Gosmann/ESP32-board/REQUISITOS/WhatsApp Image 2020-05-04 at 14.50.01 (1).jpeg

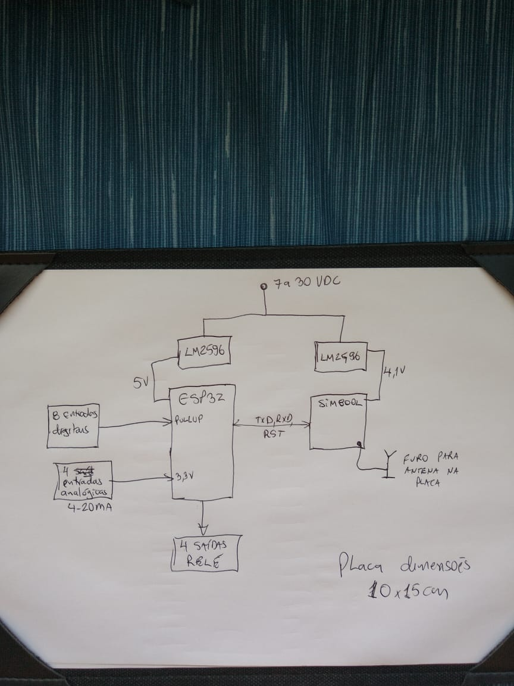
REQUISITOS/WhatsApp Image 2020-05-04 at 14.50.01 (1).jpeg
