Gosmann/ESP32-board/SIMULATIONS/LM2596 4V/4V_analise_divisor.jpg

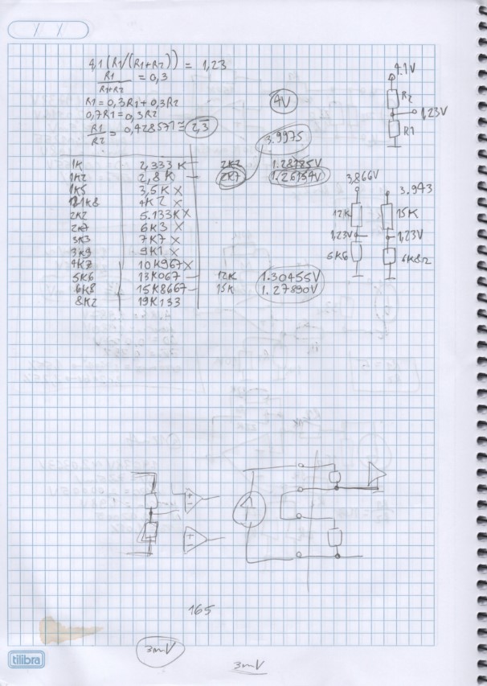
SIMULATIONS/LM2596 4V/4V_analise_divisor.jpg
