Gosmann/ESP32-board/DATASHEETS/analog_inputs.png

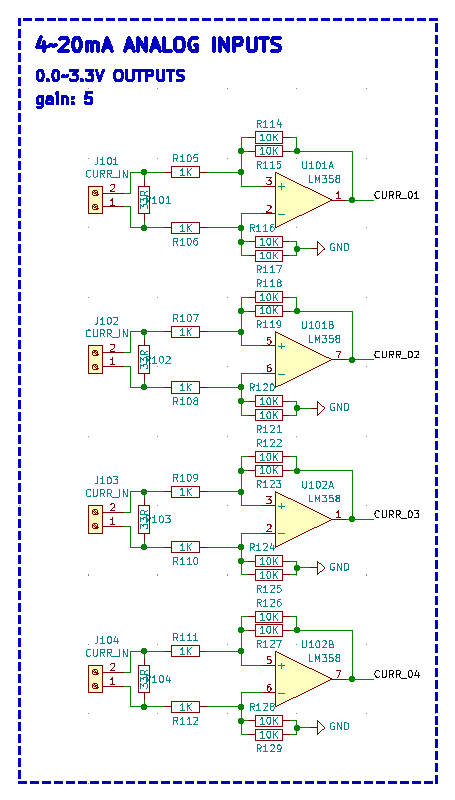
DATASHEETS/analog_inputs.png
