Gosmann/ESP32-board/DATASHEETS/BOARD.png

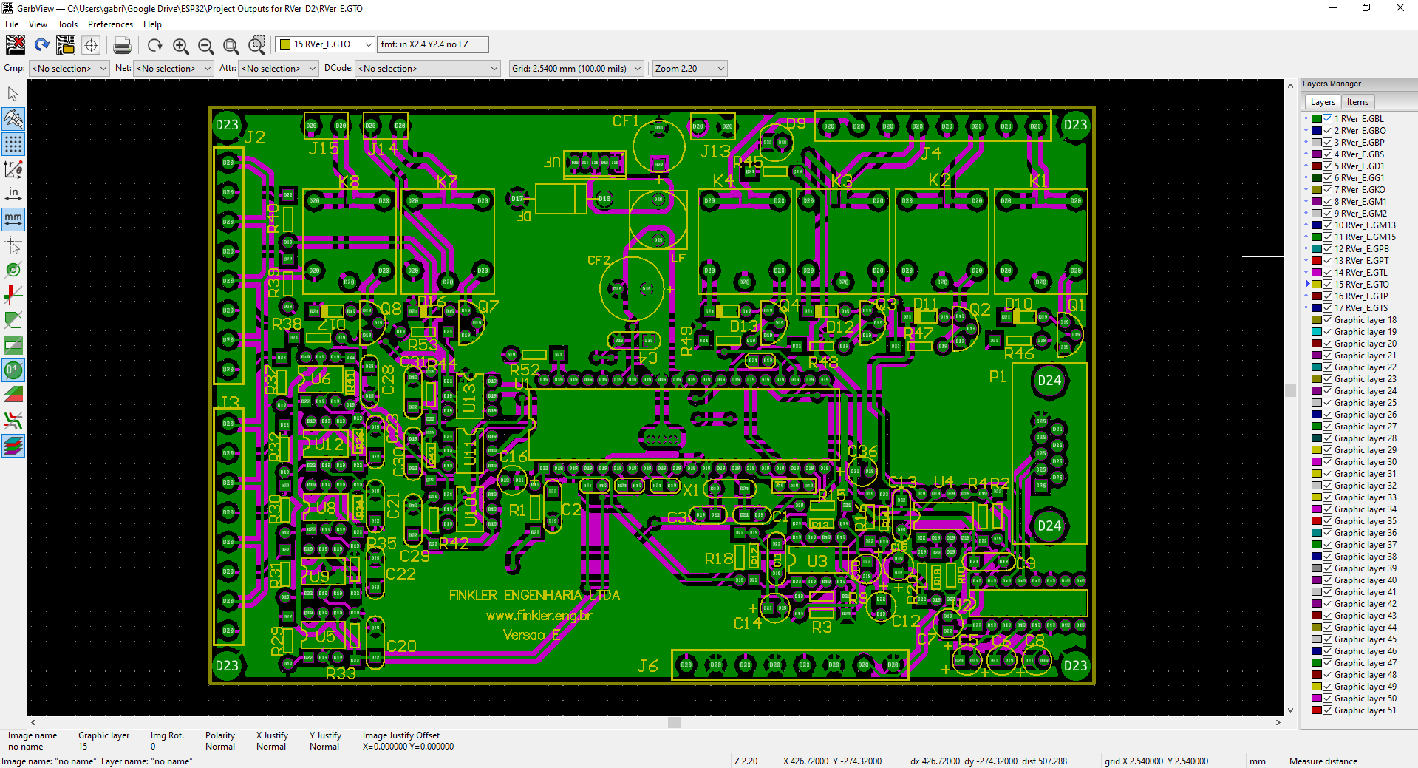
DATASHEETS/BOARD.png
