Gosmann/ESP32-board/DATASHEETS/digital_inputs.png

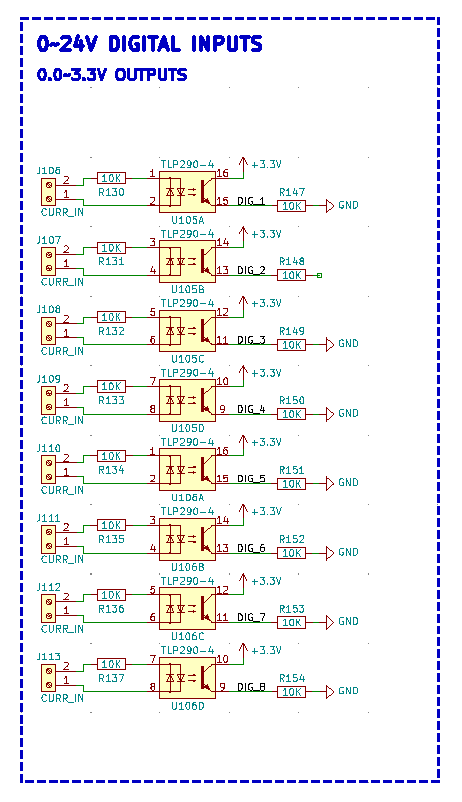
DATASHEETS/digital_inputs.png
