Gosmann/ESP32-board/DATASHEETS/digital_outputs.png

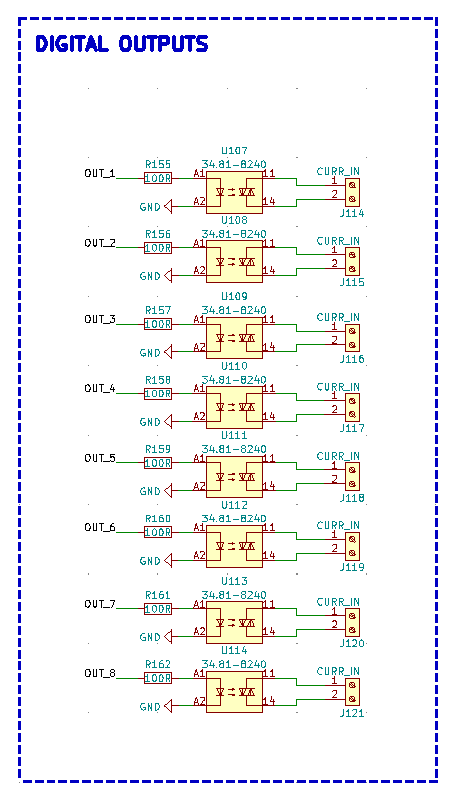
DATASHEETS/digital_outputs.png
