Gosmann/ESP32-board/DATASHEETS/ferrite.png

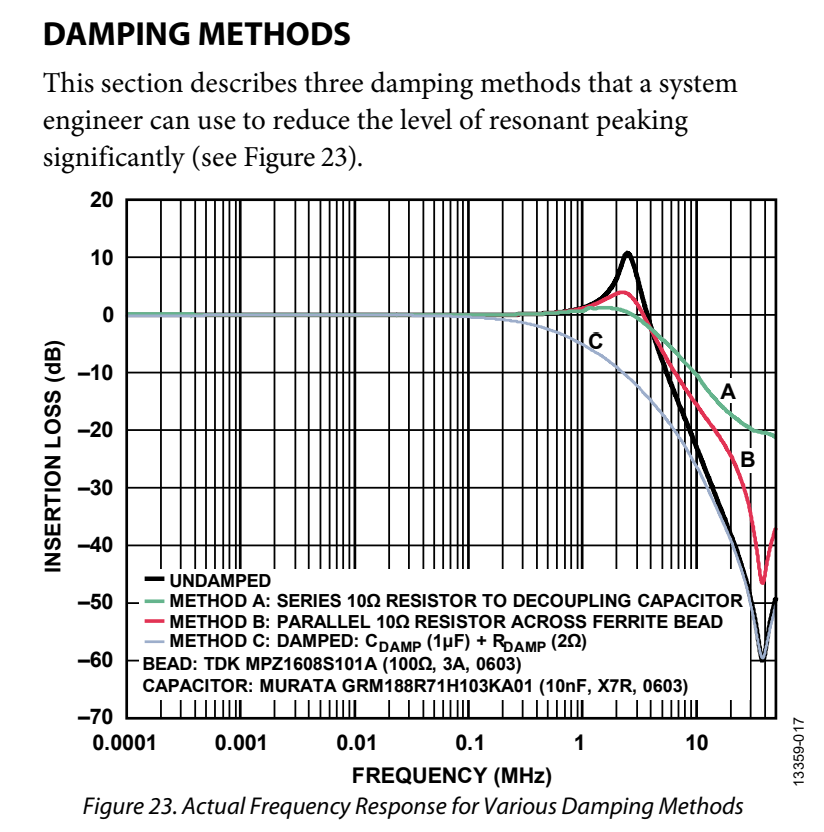
DATASHEETS/ferrite.png
