Gosmann/ESP32-board/DATASHEETS/MOC.png

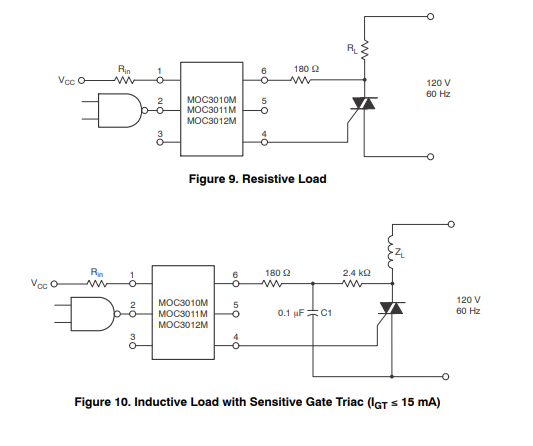
DATASHEETS/MOC.png
