Gosmann/ESP32-board/DATASHEETS/relay_max_voltage.png

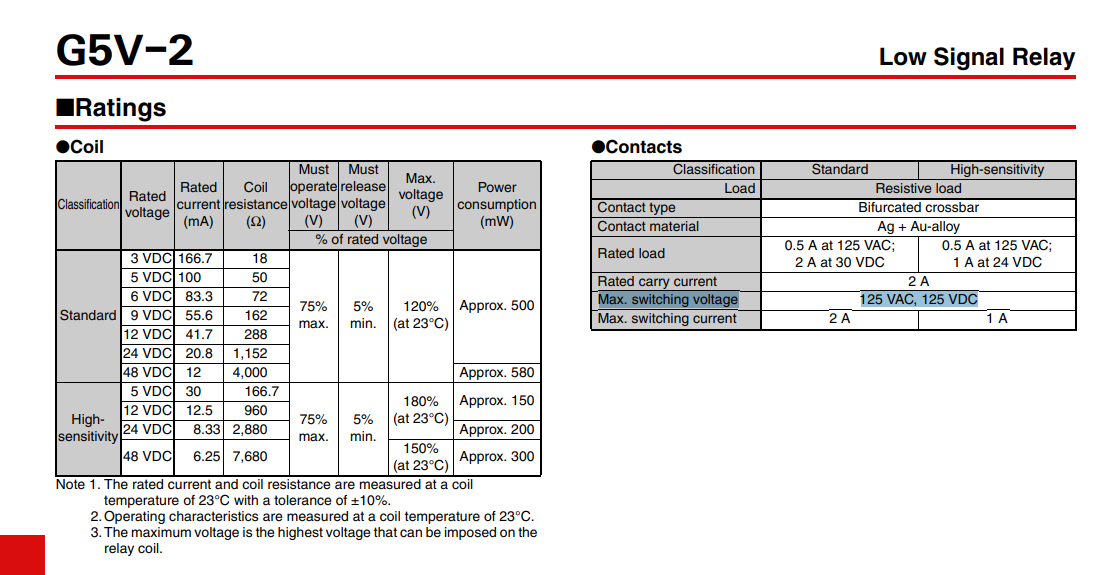
DATASHEETS/relay_max_voltage.png
