Gosmann/ESP32-board/DATASHEETS/solid_state_relay.png

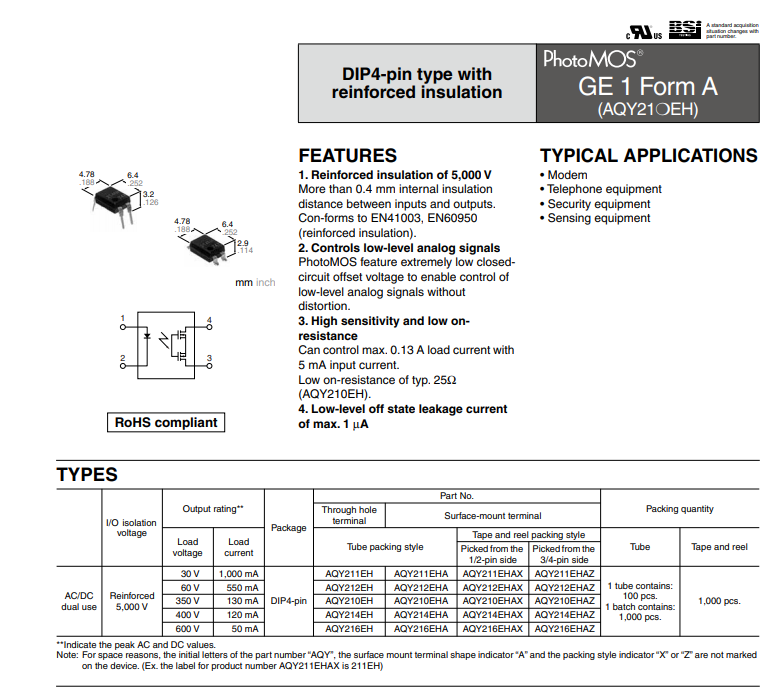
DATASHEETS/solid_state_relay.png
