Gosmann/ESP32-board/DATASHEETS/voltage_regulators.png

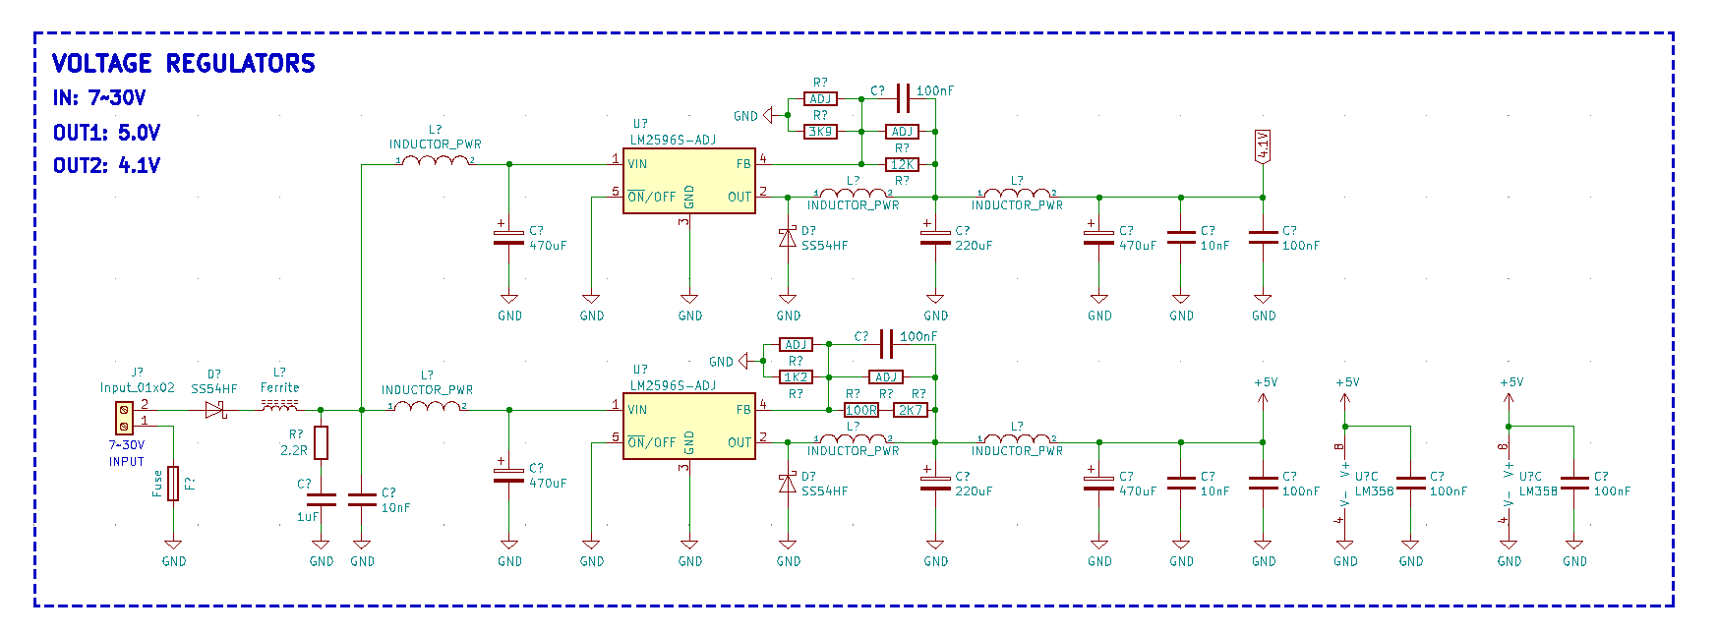
DATASHEETS/voltage_regulators.png
