Gosmann/ESP32-board/FERRITE/ferrite-beads-fig06.png

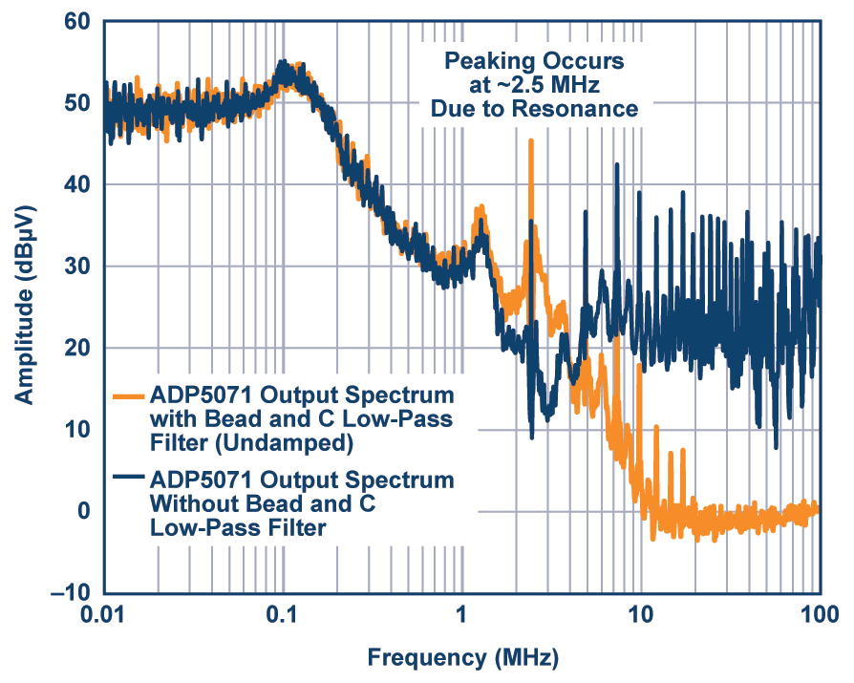
FERRITE/ferrite-beads-fig06.png
