Gosmann/ESP32-board/FERRITE/ferrite-beads-fig09.png

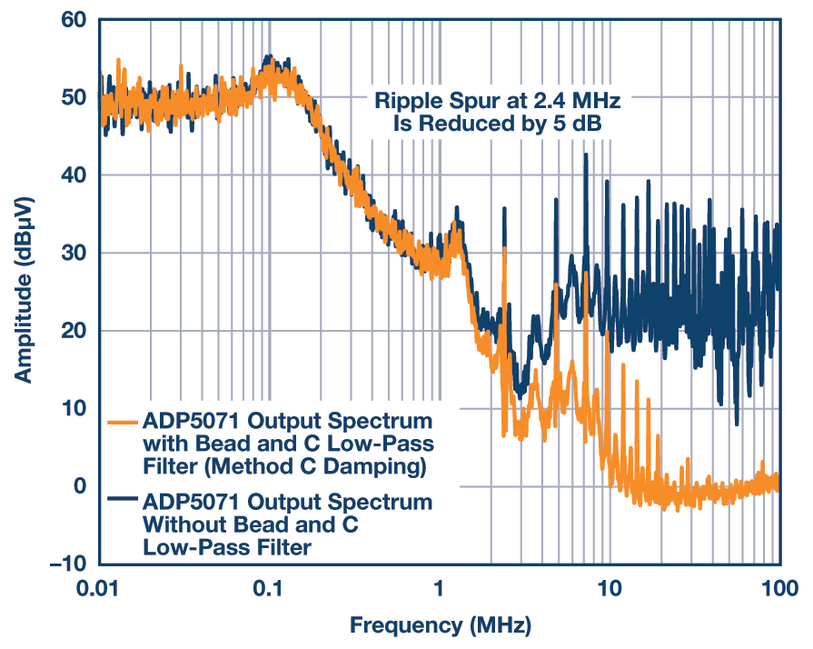
FERRITE/ferrite-beads-fig09.png
