Gosmann/ESP32-board/REQUISITOS/ESP-WROOM-32 DEV KIT.jpeg

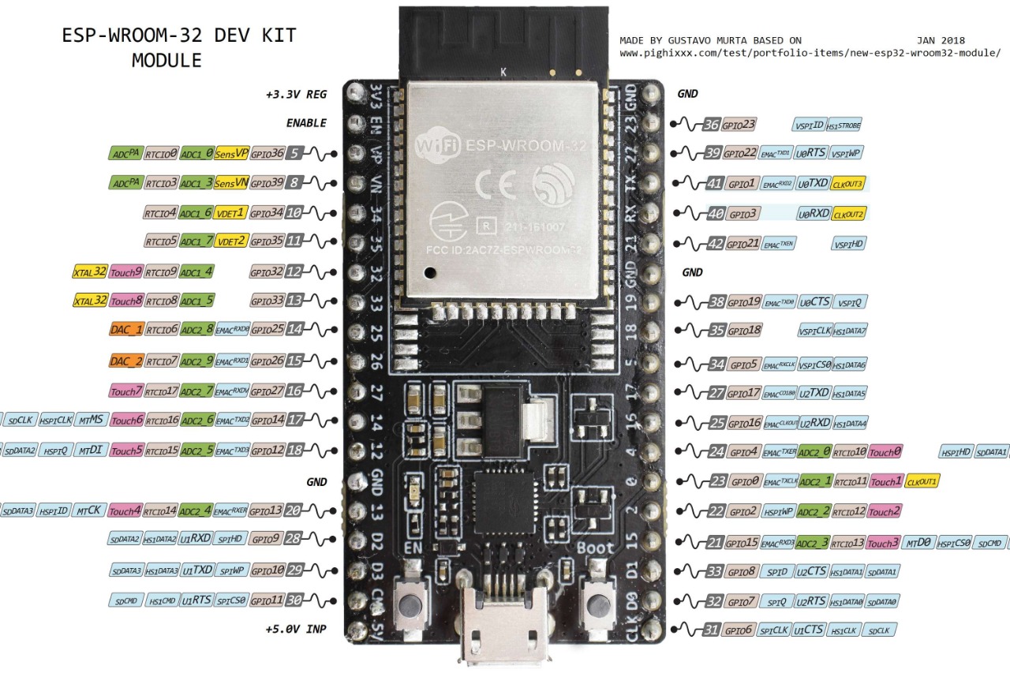
REQUISITOS/ESP-WROOM-32 DEV KIT.jpeg
