Gosmann/ESP32-board/SIMULATIONS/4-20mA/165_ohms.png

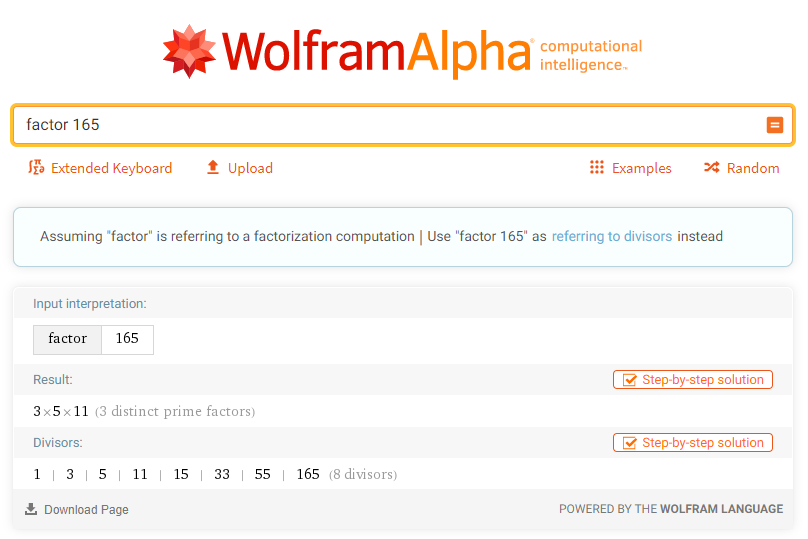
SIMULATIONS/4-20mA/165_ohms.png
