Gosmann/ESP32-board/SIMULATIONS/4-20mA/possible_topologies.jpg

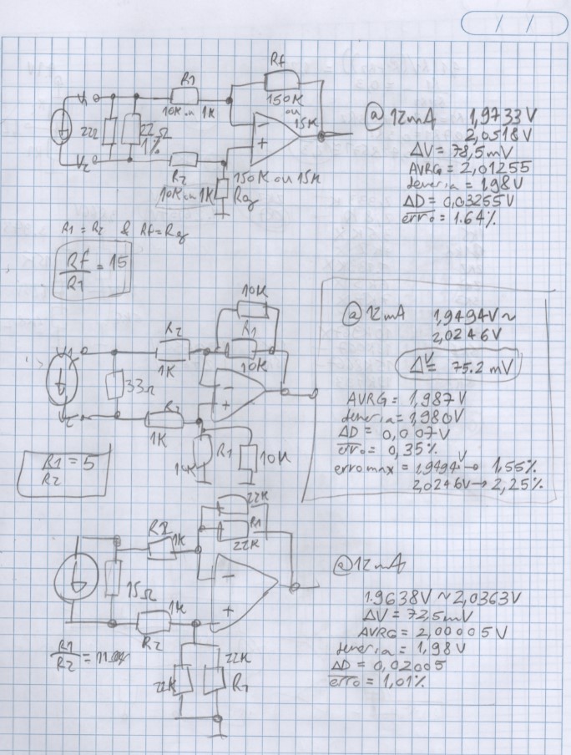
SIMULATIONS/4-20mA/possible_topologies.jpg
