Gosmann/ESP32-board/SIMULATIONS/4-20mA/sim1_mc2.png

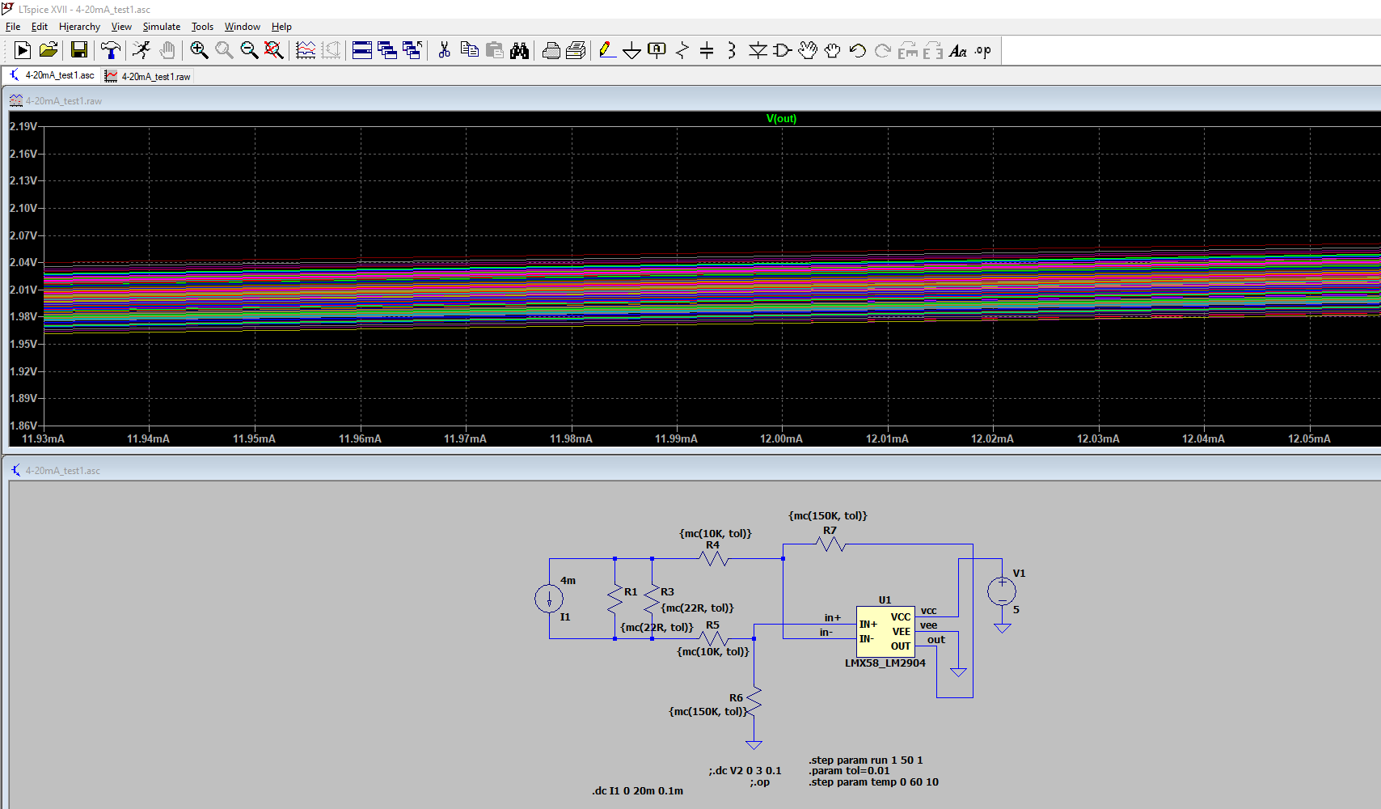
SIMULATIONS/4-20mA/sim1_mc2.png
