Gosmann/ESP32-board/SIMULATIONS/4-20mA/sim2.png

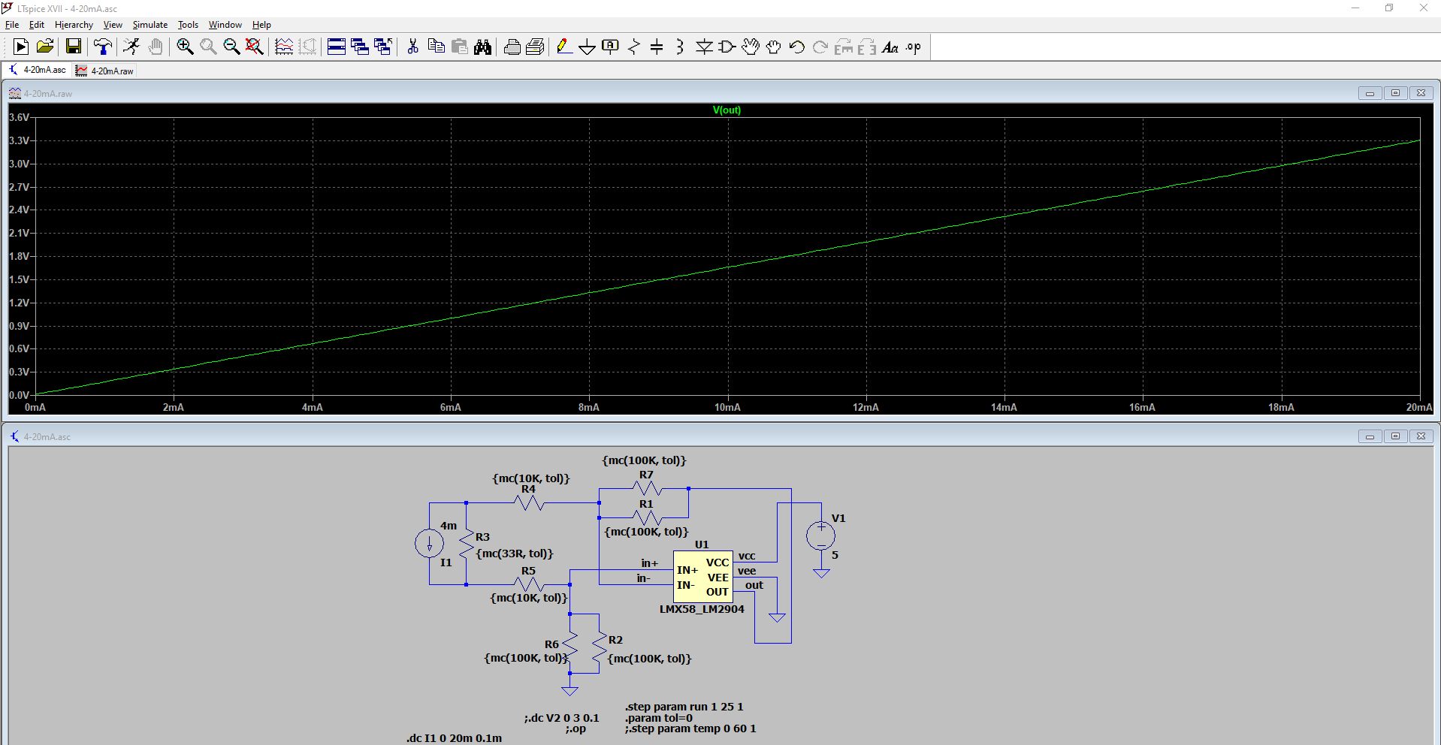
SIMULATIONS/4-20mA/sim2.png
