Gosmann/ESP32-board/SIMULATIONS/LM2596 5V/5V_analise_divisor.jpg

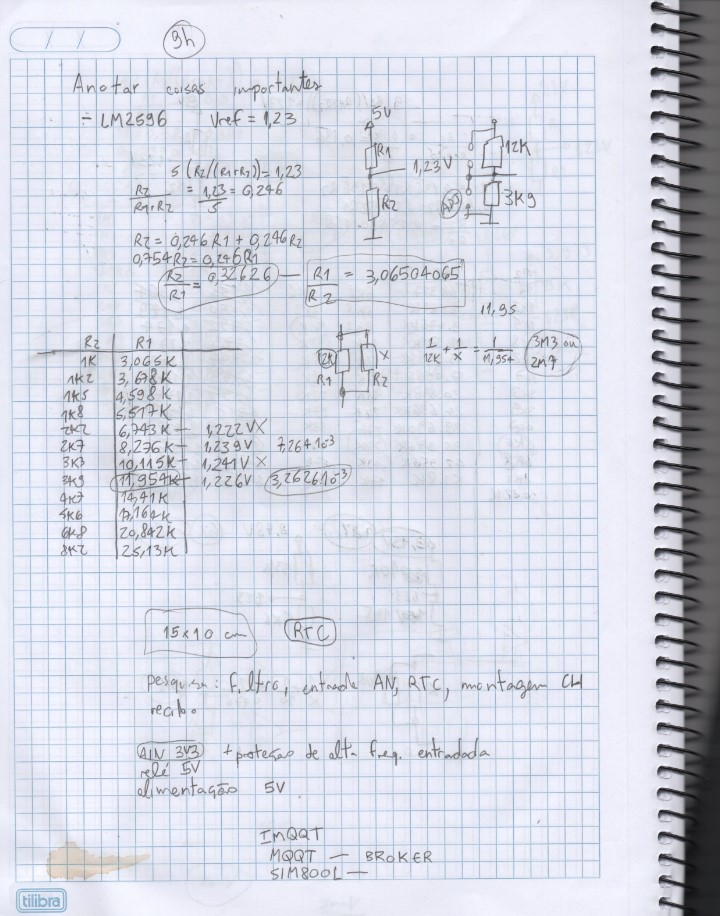
SIMULATIONS/LM2596 5V/5V_analise_divisor.jpg
