Gosmann/ESP32-board/SIMULATIONS/RELAY/relay.png

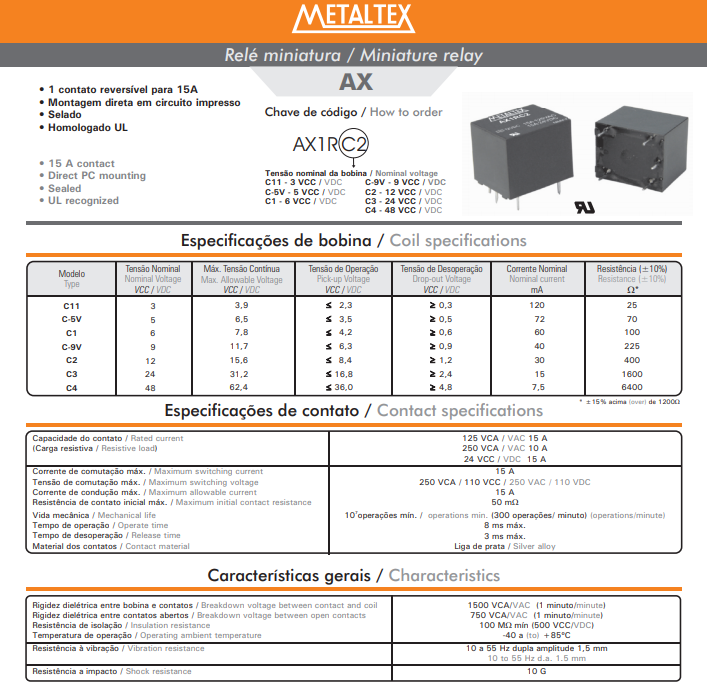
SIMULATIONS/RELAY/relay.png
