Gosmann/ESP32-board/SIMULATIONS/4-20mA/circuit_test.ods

I (mA) | V (V)
0.002 | 0.022
4.040 | 0.638
8.001 | 1.243
12.104 | 1.863
16.047 | 2.474
20.097 | 3.091
24.030 | 3.527
