Gosmann/ESP32-board/SIMULATIONS/LM2596 4V/4V_efficiency_test.png

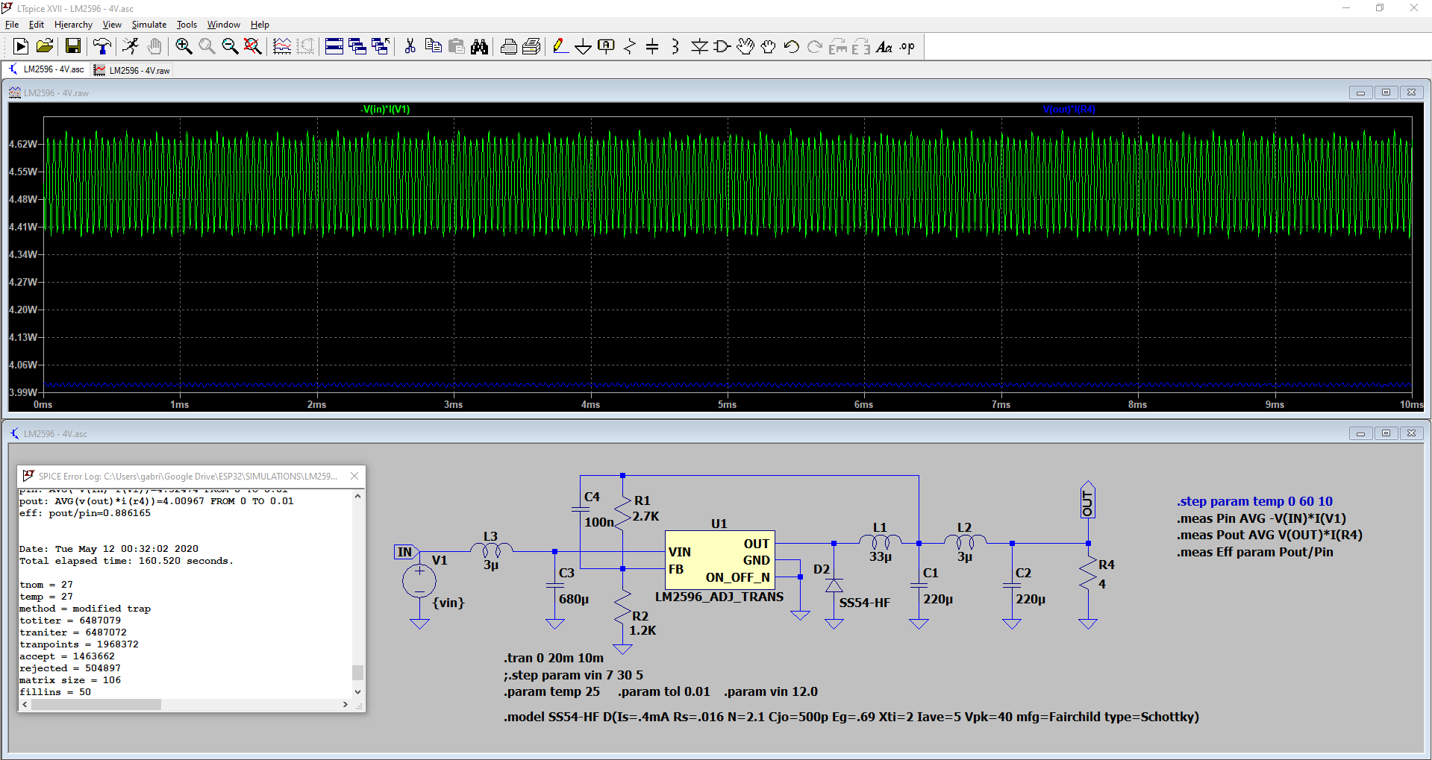
SIMULATIONS/LM2596 4V/4V_efficiency_test.png
