Gosmann/ESP32-board/SIMULATIONS/LM2596 5V/5V_efficiency_test.png

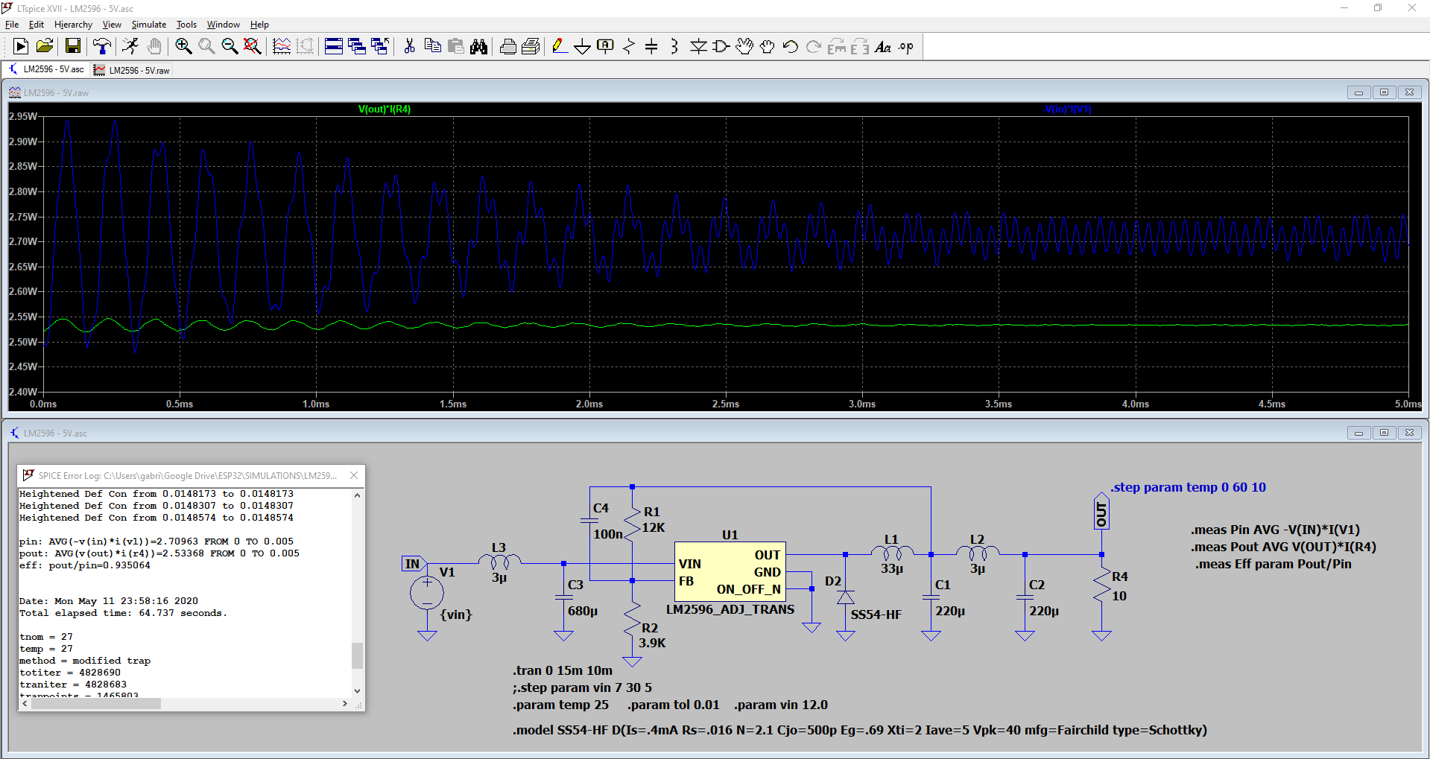
SIMULATIONS/LM2596 5V/5V_efficiency_test.png
