Gosmann/ESP32-board/SIMULATIONS/LM2596 5V/5V_ripple_test.png

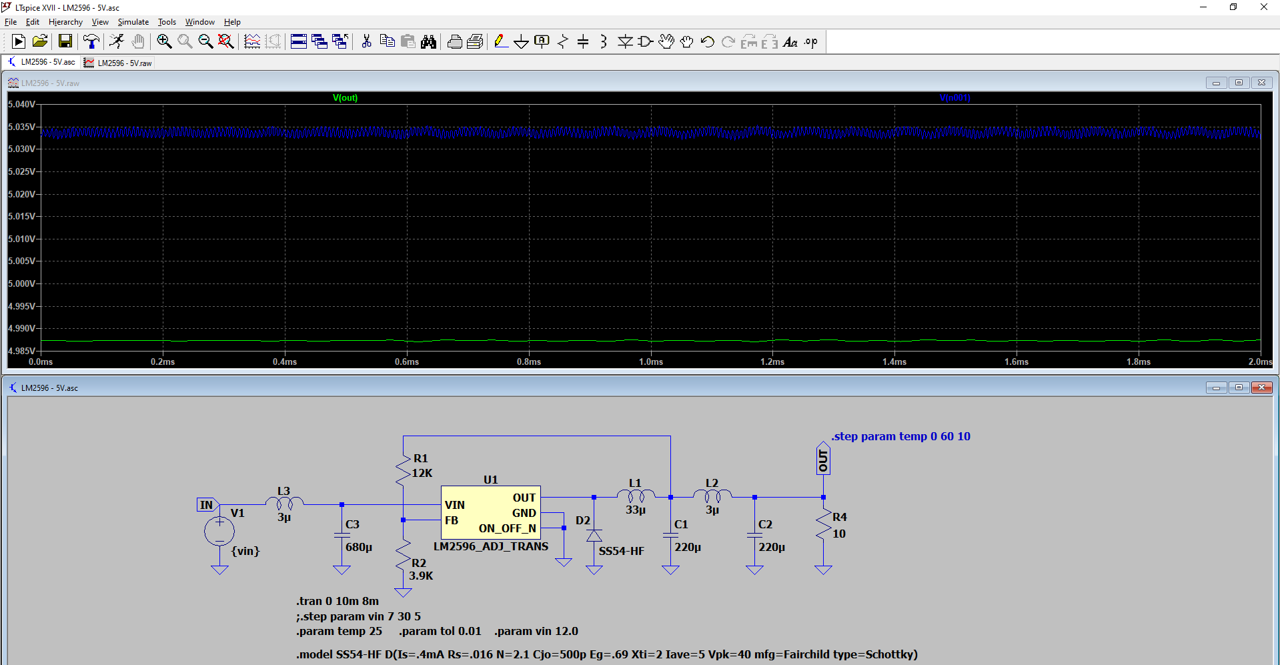
SIMULATIONS/LM2596 5V/5V_ripple_test.png
