Gosmann/ESP32-board/SIMULATIONS/LM2596 9V/RESULTS/9V_OUT_10V_IN_TEMP_SWEEP.png

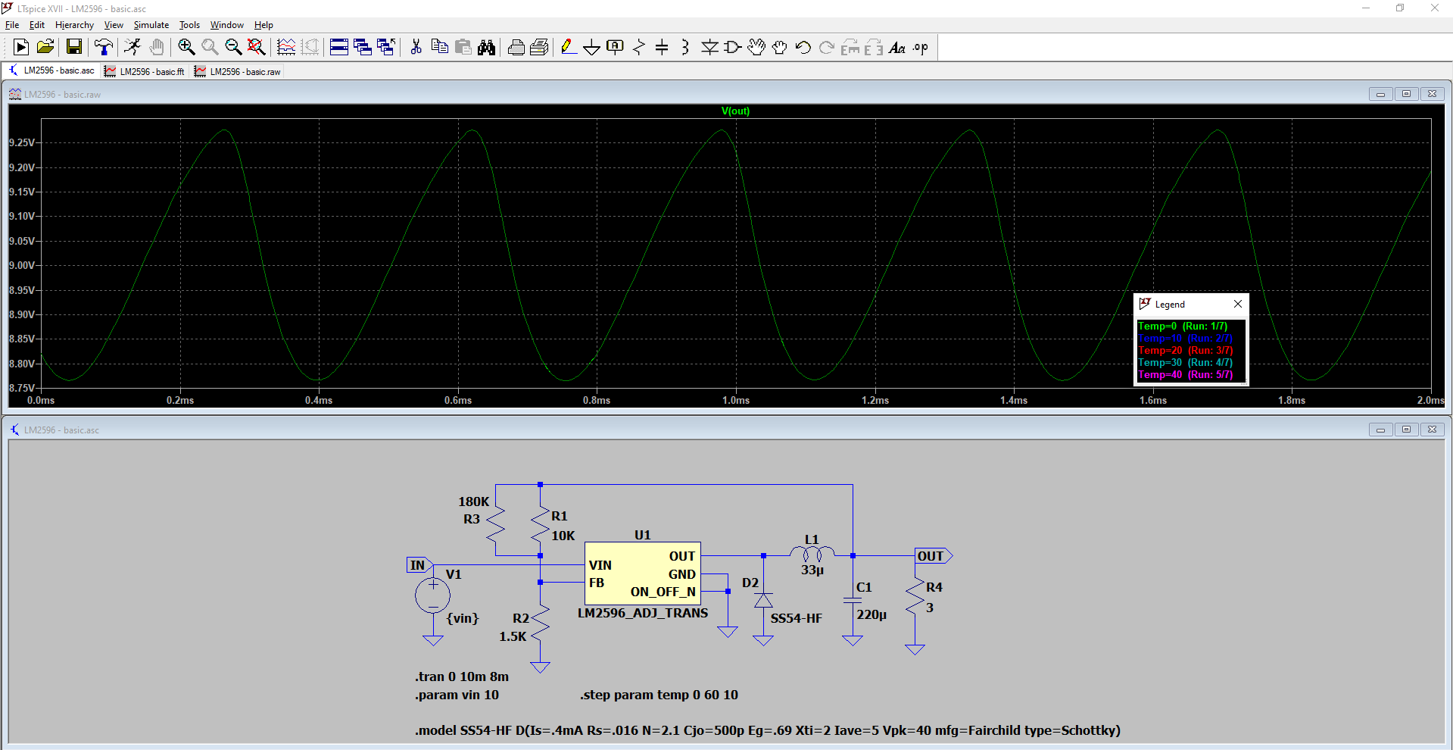
SIMULATIONS/LM2596 9V/RESULTS/9V_OUT_10V_IN_TEMP_SWEEP.png
