Gosmann/ESP32-board/SIMULATIONS/OPTO/opto_test1.png

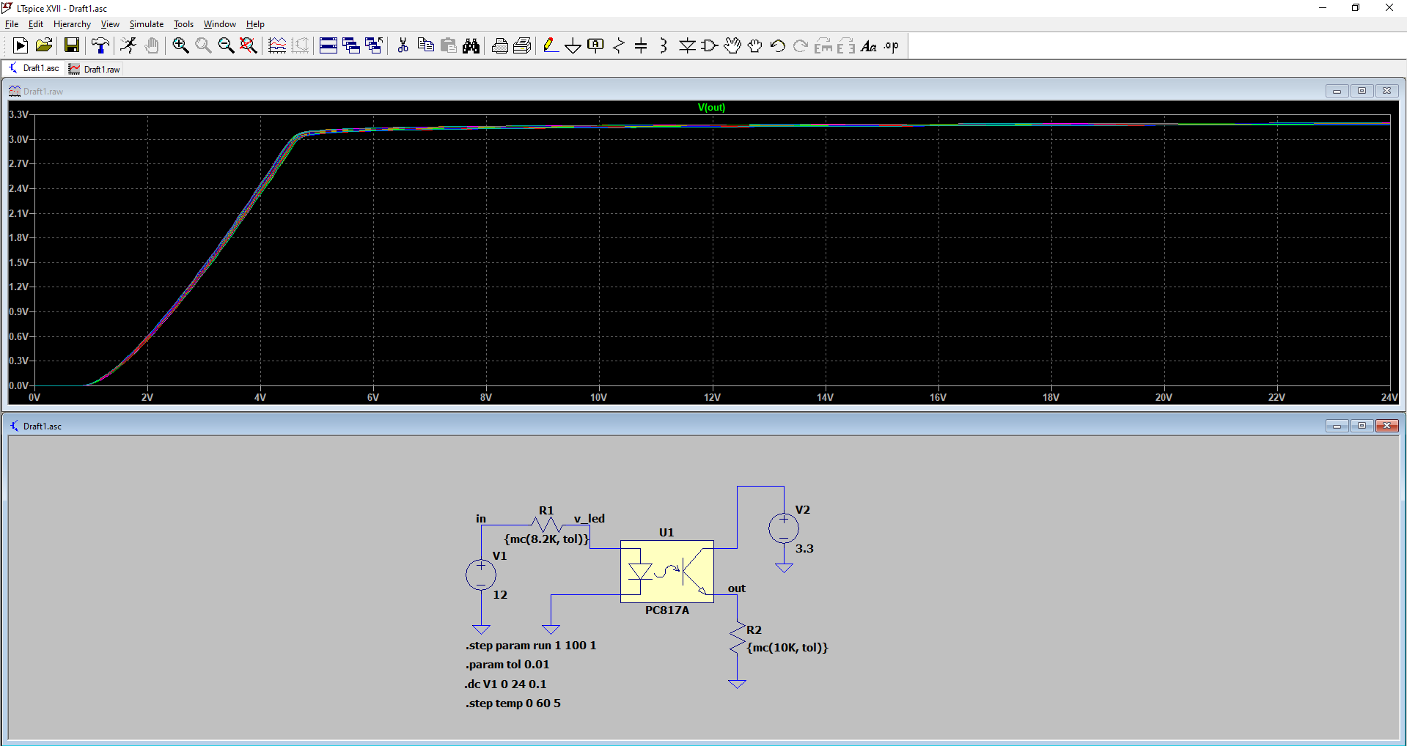
SIMULATIONS/OPTO/opto_test1.png
