Gosmann/ESP32-board/SIMULATIONS/OPTO/opto_test2.png

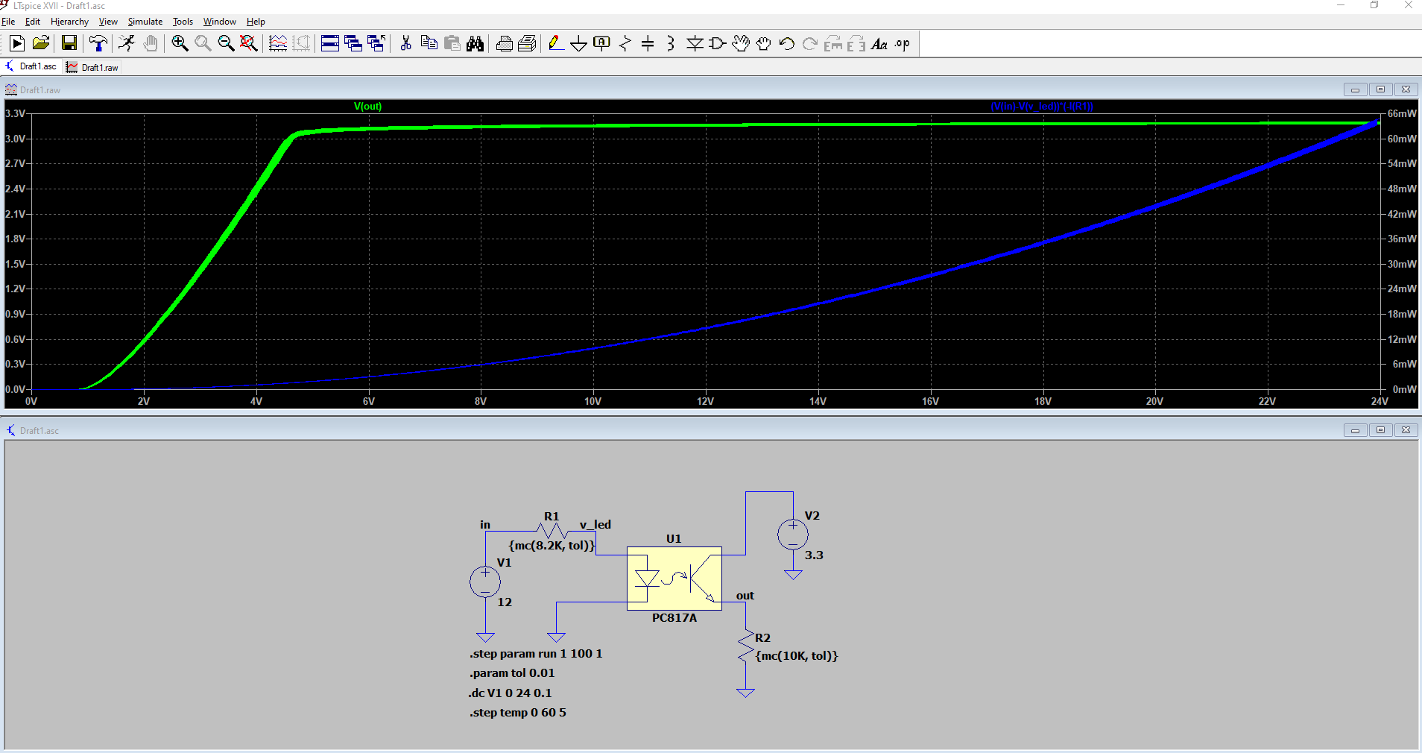
SIMULATIONS/OPTO/opto_test2.png
