Gosmann/ESP32-board/SIMULATIONS/RELAY/test_high.png

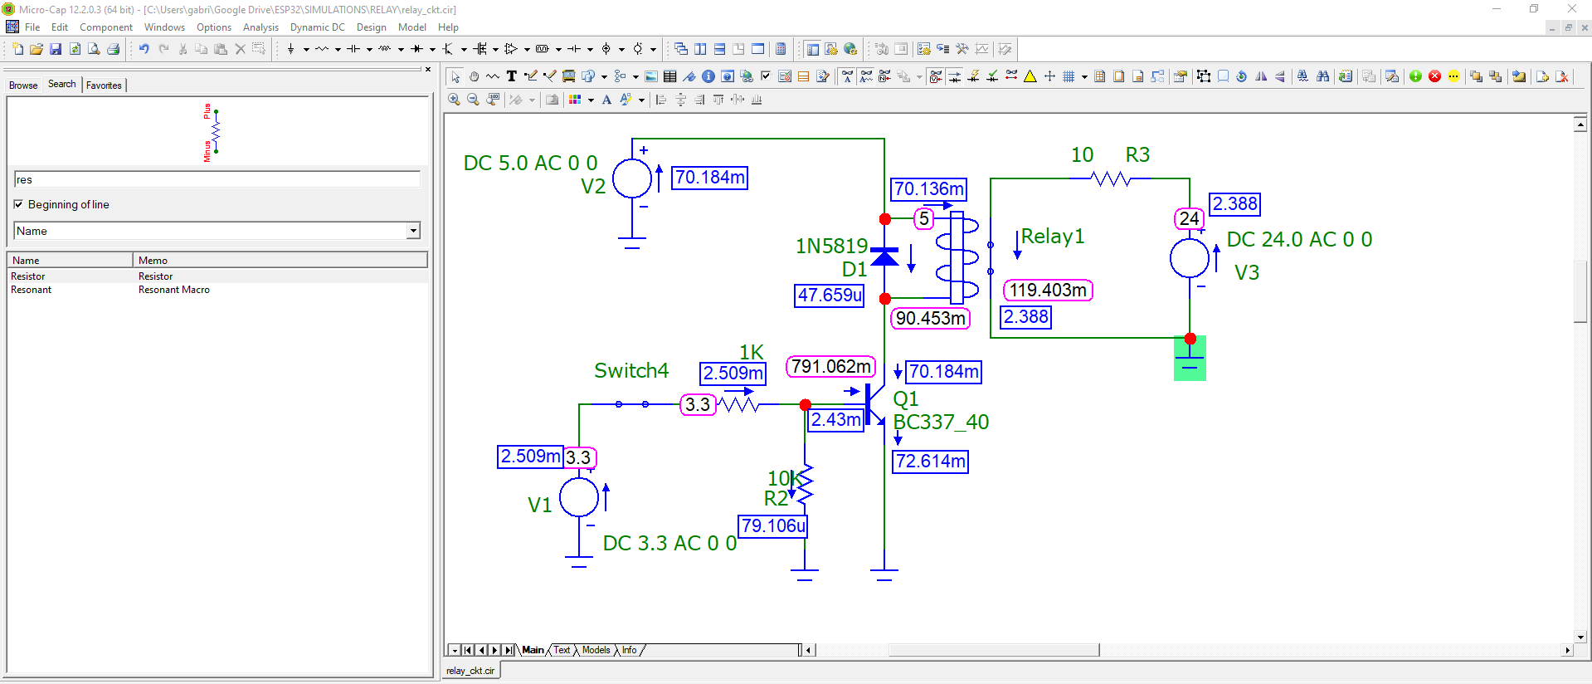
SIMULATIONS/RELAY/test_high.png
