Gosmann/ESP32-board/SIMULATIONS/RELAY/test_low.png

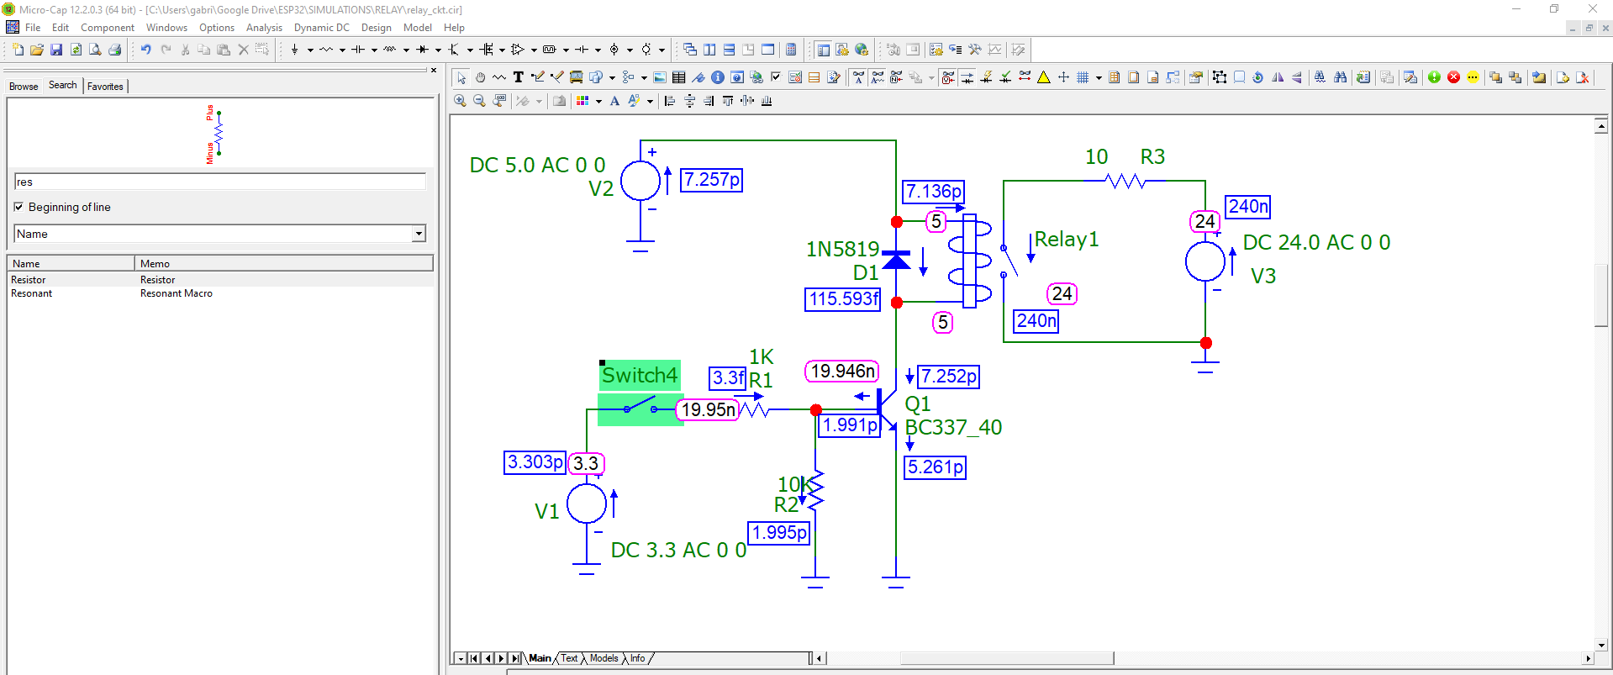
SIMULATIONS/RELAY/test_low.png
