Gosmann/ESP32-board/ESP32-BOARD/ESP32-BOARD.pdf

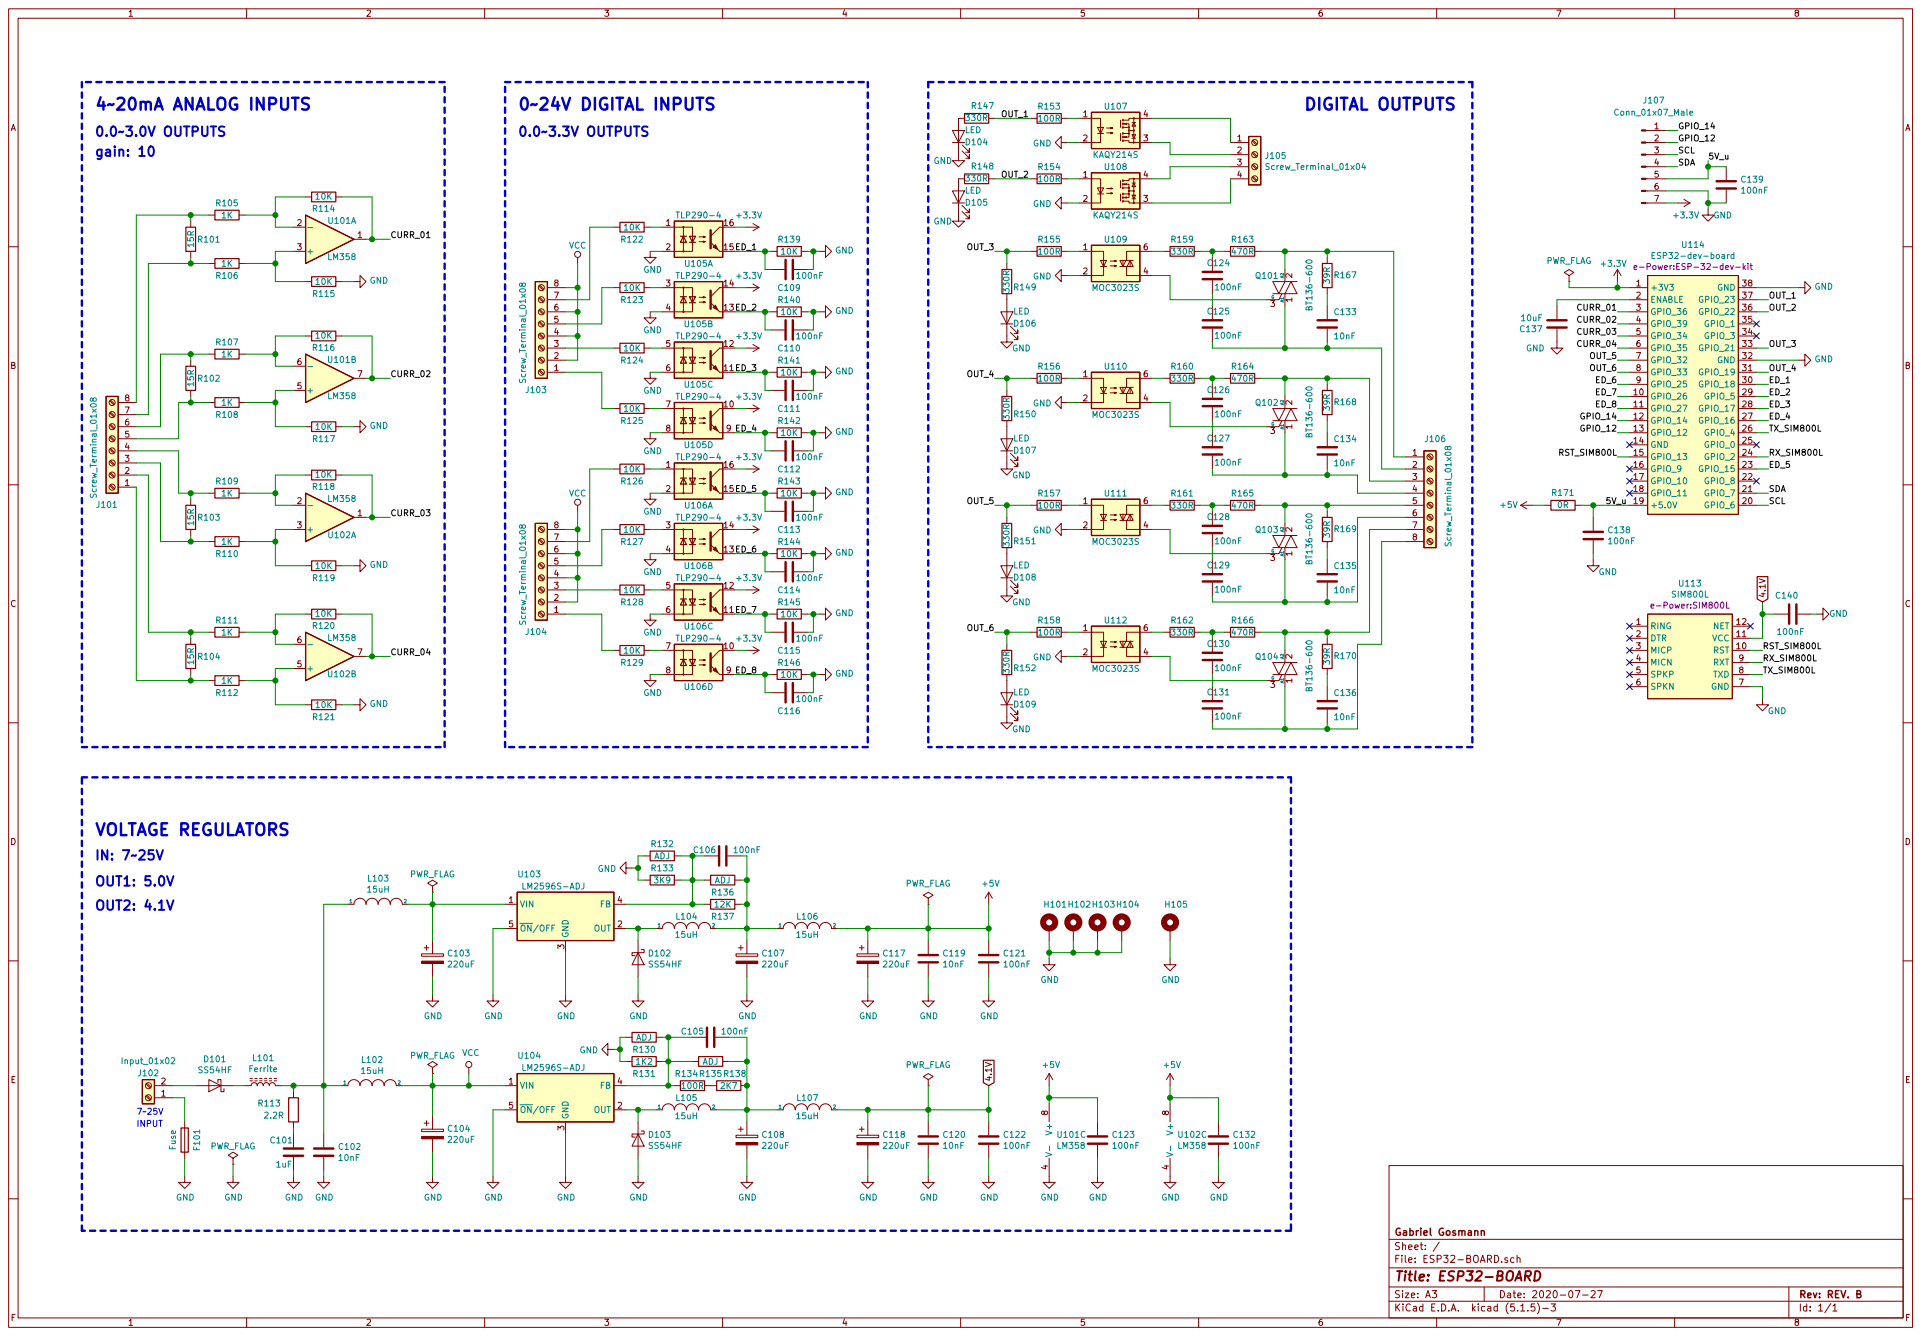
[picture p40: page 1]

e-Power:ESP-32-dev-kit 1

File: ESP32-BOARD.sch Sheet: / Gabriel Gosmann
