Gosmann/ESP32-board/SIMULATIONS/4-20mA/4-20mA_test1.asc

I1: current; 4m
R1: res; {mc(100K, tol)}
R2: res; {mc(100K, tol)}
R3: res; {mc(33R, tol)}; tol=1
R4: res; {mc(10K, tol)}
R5: res; {mc(10K, tol)}
R6: res; {mc(100K, tol)}
R7: res; {mc(100K, tol)}
U1: LMX58_LM2904
V1: voltage; 5
Named nets: 0, out, vcc, vee, in-, in+
;.dc V2 0 3 0.1
.step param run 1 50 1
.param tol=0.01
.step param temp 0 60 10
;.op
.dc I1 0 20m 0.1m
