Gosmann/ESP32-board/SIMULATIONS/MODELS/moc_308x_test.asc

R1: res; 10R
R9: res; 100
U2: TRIAC; BTA12-600B
V1: voltage; SINE(0 400 50)
Named nets: 0, 3, 2
.tran 200m
.include MOC308x.lib
.include C:\\Users\\gabri\\Google Drive\\ESP32\\SIMULATIONS\\MODELS\\st_standard_snubberless_triacs.lib
