Gosmann/ESP32-board/SIMULATIONS/4-20mA/4-20mA.asc

U1: LMX58_LM2904
V1: voltage; 5
Named nets: 0, out, vcc, vee, in-, in+
.tran 0 10m 0
