Gosmann/ESP32-board/SIMULATIONS/LM2596 4V/LM2596 - 4V.asc

C1: cap; 220µ
C2: cap; 220µ
C3: cap; 680µ
C4: cap; 100n
D2: diode; SS54-HF
L1: ind; 15µ; Rser=0.093
L2: ind; 15µ; Rser=0
L3: ind; 15µ; Rser=0.093
R1: res; 2.7K
R2: res; 1.2K
R4: res; 4; tol=1
U1: LM2596_ADJ_TRANS
V1: voltage; {vin}
Named nets: 0, OUT, IN
.tran 0 100m 10m
.model SS54-HF D(Is=.4mA Rs=.016 N=2.1 Cjo=500p Eg=.69 Xti=2 Iave=5 Vpk=40 mfg=Fairchild type=Schottky)
;.step param vin 7 30 5
.param temp 25
.step param temp 0 60 10
.param tol 0.01
.param vin 12.0
.meas Pin AVG -V(IN)*I(V1)
.meas Pout AVG V(OUT)*I(R4)
.meas Eff param Pout/Pin
