Gosmann/ESP32-board/SIMULATIONS/LM2596 5V/LM2596 - 5V.asc

C1: cap; 220µ
D2: diode; SS54-HF
L1: ind; 33µ; Rser=0.093
R1: res; 10K; tol=1
R2: res; 1.5K; tol=1
R3: res; 180K; tol=1
R4: res; 18; tol=1
U1: LM2596_ADJ_TRANS
V1: voltage; {vin}
Named nets: 0, OUT, IN
.tran 0 10m 8m
.model SS54-HF D(Is=.4mA Rs=.016 N=2.1 Cjo=500p Eg=.69 Xti=2 Iave=5 Vpk=40 mfg=Fairchild type=Schottky)
.param vin=16.8
.param temp 25
.step param temp 0 60 10
