Gosmann/ESP32-board/SIMULATIONS/OPTO/opto.asc

R1: res; {mc(8.2K, tol)}
R2: res; {mc(10K, tol)}
U1: PC817A
V1: voltage; 12
V2: voltage; 3.3
Named nets: 0, out, v_led, in
.dc V1 0 24 0.1
.step temp 0 60 5
.param tol 0.01
.step param run 1 100 1
