Gosmann/ESP32-board/(list of files, drawings)

Other design files:
Project Outputs for modem2/Project Outputs for modem/PCB2.PcbDoc
SIMULATIONS/MODELS/en.standard_snubberless_triacs_pspice (1)/standard_snubberless_triacs_Pspice/st_standard_snubberless_triacs.olb
