Gosmann/ESP32-board/ESP32-BOARD/ESP32-BOARD.kicad_pcb

## KiCad design ESP32-BOARD/ESP32-BOARD.kicad_pcb (2020-11-04)

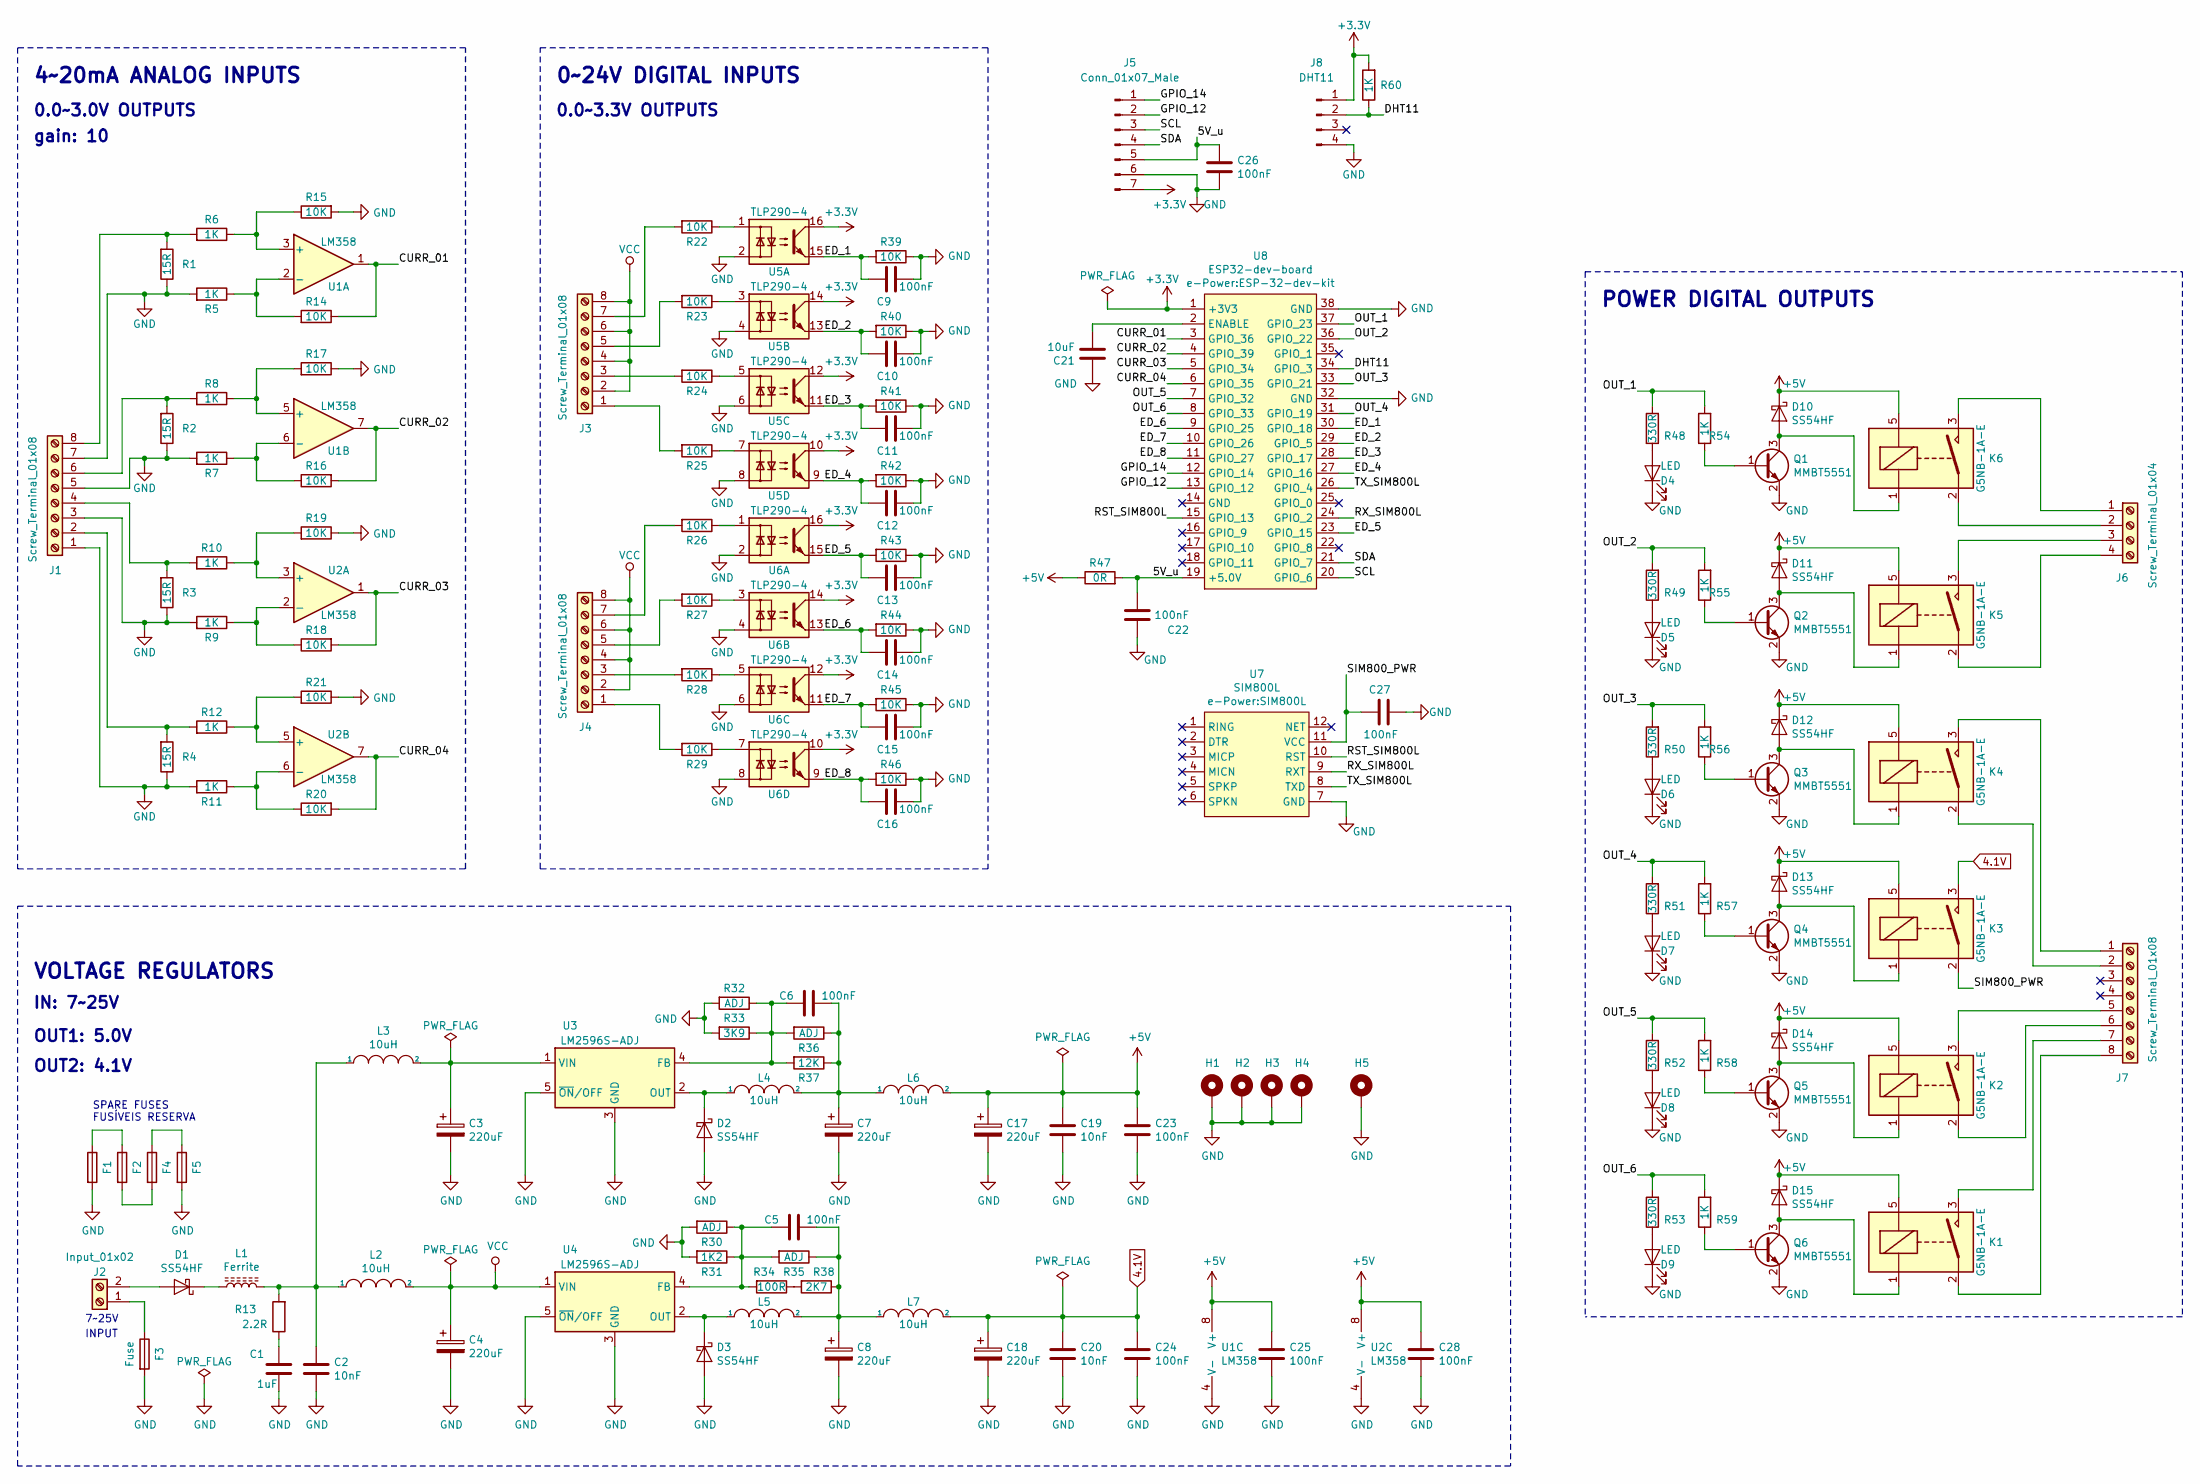
[picture p41: schematic ESP32-BOARD.sch]

Parts:
C1: 1uF; C_0805_2012Metric; LCSC C28323
C2, C19, C20: 10nF; C_0805_2012Metric; LCSC C1710
C3, C4, C7, C8, C17, C18: 220uF; CP_Elec_8x10; LCSC C311611
C5, C6, C9, C10, C11, C12, C13, C14, C15, C16, C22, C23, C24, C25, C26, C27, C28: 100nF; C_0805_2012Metric; LCSC C49678
C21: 10uF; C_0805_2012Metric; LCSC C15850
D1, D2, D3, D10, D11, D12, D13, D14, D15: SS54HF; DO-214AC; LCSC C22452
D4, D5, D6, D7, D8, D9: LED; LED_0805_2012Metric; LCSC C84256
F1, F2, F3, F4, F5: Fuse; FUSE_1206_3216Metric; LCSC C182445
H1, H2, H3, H4: MountingHole_Pad; MountingHole_4mm_Pad_Via
H5: MountingHole_Pad; MountingHole_3.2mm_M3_Pad
J1, J3, J4, J7: Screw_Terminal_01x08; TerminalBlock_Phoenix_MKDS-1,5-8-5.08_1x08_P5.08mm_Horizont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
J2: Input_01x02; TerminalBlock_Phoenix_MKDS-1,5-2_1x02_P5.00mm_Horizontal
J5: Conn_01x07_Male; PinHeader_1x07_P2.54mm_Horizontal
J6: Screw_Terminal_01x04; TerminalBlock_Phoenix_MKDS-1,5-4-5.08_1x04_P5.08mm_Horizont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
J8: DHT11; PinHeader_1x04_P2.54mm_Vertical
K1, K2, K3, K4, K5, K6: G5NB-1A-E; Relay_SPST_Omron-G5Q-1A
L1: Ferrite; FB_0603_1608Metric; LCSC C1002
L2, L3, L4, L5, L6, L7: 10uH; L_10.4x10.4_H4.8; LCSC C9935
Q1, Q2, Q3, Q4, Q5, Q6: MMBT5551; SOT-23; LCSC C2145
R1, R2, R3, R4: 15R; R_0805_2012Metric; LCSC C17480
R5, R6, R7, R8, R9, R10, R11, R12, R54, R55, R56, R57, R58, R59, R60: 1K; R_0805_2012Metric; LCSC C17513
R13: 2.2R; R_0805_2012Metric; LCSC C17521
R14, R15, R16, R17, R18, R19, R20, R21, R22, R23, R24, R25, R26, R27, R28, R29, R39, R40, R41, R42, R43, R44, R45, R46: 10K; R_0805_2012Metric; LCSC C17414
R30, R32, R35, R36: ADJ; R_0805_2012Metric
R31: 1K2; R_0805_2012Metric; LCSC C17379
R33: 3K9; R_0805_2012Metric; LCSC C17614
R34: 100R; R_0805_2012Metric; LCSC C17408
R37: 12K; R_0805_2012Metric; LCSC C17444
R38: 2K7; R_0805_2012Metric; LCSC C17530
R47: 0R; R_0805_2012Metric; LCSC C17477
R48, R49, R50, R51, R52, R53: 330R; R_0805_2012Metric; LCSC C17630
U1, U2: LM358; SOIC-8_3.9x4.9mm_P1.27mm; LCSC C7950
U3, U4: LM2596S-ADJ; TO-263-5_TabPin3; LCSC C52684
U5, U6: TLP290-4; SOIC-16_4.55x10.3mm_P1.27mm(TLP290-4); LCSC C39031
U7: SIM800L
U8: ESP32-dev-board; ESP-32-dev-kit

Connections:
4.1V: C18.1, C20.1, C24.1, K3.3, L7.2
+3V3: J5.7, J8.1, R60.2, U5.10, U5.12, U5.14, U5.16, U6.10, U6.12, U6.14, U6.16, U8.1 (+3V3)
+5V: C17.1, C19.1, C23.1, C25.1, C28.1, D10.1 (K), D11.1 (K), D12.1 (K), D13.1 (K), D14.1 (K), D15.1 (K), K1.5, K2.5, K3.5, K4.5, K5.5, K6.5, L6.2, R47.1, U1.8 (V+), U2.8 (V+)
/5V_u: C22.2, C26.1, J5.5, R47.2, U8.19 (+5.0V)
/CURR_01: R14.1, U1.1, U8.3 (GPIO_36)
/CURR_02: R16.2, U1.7, U8.4 (GPIO_39)
/CURR_03: R18.2, U2.1, U8.5 (GPIO_34)
/CURR_04: R20.2, U2.7, U8.6 (GPIO_35)
/DHT11: J8.2, R60.1, U8.34 (GPIO_3)
/ED_1: C9.2, R39.2, U5.15, U8.30 (GPIO_18)
/ED_2: C10.2, R40.2, U5.13, U8.29 (GPIO_5)
/ED_3: C11.2, R41.2, U5.11, U8.28 (GPIO_17)
/ED_4: C12.2, R42.2, U5.9, U8.27 (GPIO_16)
/ED_5: C13.2, R43.2, U6.15, U8.23 (GPIO_15)
/ED_6: C14.2, R44.2, U6.13, U8.9 (GPIO_25)
/ED_7: C15.2, R45.2, U6.11, U8.10 (GPIO_26)
/ED_8: C16.2, R46.2, U6.9, U8.11 (GPIO_27)
/GPIO_12: J5.2, U8.13 (GPIO_12)
/GPIO_14: J5.1, U8.12 (GPIO_14)
/OUT_1: R48.2, R54.2, U8.37 (GPIO_23)
/OUT_2: R49.2, R55.2, U8.36 (GPIO_22)
/OUT_3: R50.2, R56.2, U8.33 (GPIO_21)
/OUT_4: R51.2, R57.2, U8.31 (GPIO_19)
/OUT_5: R52.2, R58.2, U8.7 (GPIO_32)
/OUT_6: R53.2, R59.2, U8.8 (GPIO_33)
/RST_SIM800L: U7.10 (RST), U8.15 (GPIO_13)
/RX_SIM800L: U7.9 (RXT), U8.24 (GPIO_2)
/SCL: J5.3, U8.20 (GPIO_6)
/SDA: J5.4, U8.21 (GPIO_7)
/SIM800_PWR: C27.1, K3.2, U7.11 (VCC)
/TX_SIM800L: U7.8 (TXD), U8.26 (GPIO_4)
GND: C1.2, C2.2, C3.2, C4.2, C7.2, C8.2, C9.1, C10.1, C11.1, C12.1, C13.1, C14.1, C15.1, C16.1, C17.2, C18.2, C19.2, C20.2, C21.1, C22.1, C23.2, C24.2, C25.2, C26.2, C27.2, C28.2, D2.2 (A), D3.2 (A), D4.1 (K), D5.1 (K), D6.1 (K), D7.1 (K), D8.1 (K), D9.1 (K), F1.2, F3.2, F5.2, H1.1, H2.1, H3.1, H4.1, H5.1, J1.1, J1.3, J1.5, J1.7, J5.6, J8.4, Q1.2 (E), Q2.2 (E), Q3.2 (E), Q4.2 (E), Q5.2 (E), Q6.2 (E), R1.1, R2.1, R3.1, R4.1, R5.2, R7.2, R9.2, R11.2, R15.2, R17.1, R19.1, R21.1, R30.2, R31.2, R32.2, R33.2, R39.1, R40.1, R41.1, R42.1, R43.1, R44.1, R45.1, R46.1, U1.4 (V-), U2.4 (V-), U3.3 (GND), U3.5 (~ON~/OFF), U4.3 (GND), U4.5 (~ON~/OFF), U5.2, U5.4, U5.6, U5.8, U6.2, U6.4, U6.6, U6.8, U7.7 (GND), U8.32 (GND), U8.38 (GND)
unnamed: C1.1, R13.1
unnamed: C2.1, L1.2, L2.1, L3.1, R13.2
unnamed: C3.1, L3.2, U3.1 (VIN)
unnamed: C5.1, C8.1, L5.2, L7.1, R35.1, R38.1
unnamed: C5.2, R30.1, R31.1, R34.2, R35.2, U4.4 (FB)
unnamed: C6.1, C7.1, L4.2, L6.1, R36.1, R37.1
unnamed: C6.2, R32.1, R33.1, R36.2, R37.2, U3.4 (FB)
unnamed: C21.2, U8.2 (ENABLE)
unnamed: D1.1 (K), L1.1
unnamed: D1.2 (A), J2.2
unnamed: D2.1 (K), L4.1, U3.2 (OUT)
unnamed: D3.1 (K), L5.1, U4.2 (OUT)
unnamed: D4.2 (A), R48.1
unnamed: D5.2 (A), R49.1
unnamed: D6.2 (A), R50.1
unnamed: D7.2 (A), R51.1
unnamed: D8.2 (A), R52.1
unnamed: D9.2 (A), R53.1
unnamed: D10.2 (A), K6.1, Q1.3 (C)
unnamed: D11.2 (A), K5.1, Q2.3 (C)
unnamed: D12.2 (A), K4.1, Q3.3 (C)
unnamed: D13.2 (A), K3.1, Q4.3 (C)
unnamed: D14.2 (A), K2.1, Q5.3 (C)
unnamed: D15.2 (A), K1.1, Q6.3 (C)
unnamed: F1.1, F2.1
unnamed: F2.2, F4.2
unnamed: F3.1, J2.1
unnamed: F4.1, F5.1
unnamed: J1.2, R4.2, R12.2
unnamed: J1.4, R3.2, R10.2
unnamed: J1.6, R2.2, R8.2
unnamed: J1.8, R1.2, R6.2
unnamed: J3.1, R25.2
unnamed: J3.3, R24.2
unnamed: J3.5, R23.2
unnamed: J3.7, R22.2
unnamed: J4.1, R29.2
unnamed: J4.3, R28.2
unnamed: J4.5, R27.2
unnamed: J4.7, R26.2
unnamed: J6.1, K6.3
unnamed: J6.2, K6.2
unnamed: J6.3, K5.3
unnamed: J6.4, K5.2
unnamed: J7.1, K4.3
unnamed: J7.2, K4.2
unnamed: J7.5, K2.3
unnamed: J7.6, K2.2
unnamed: J7.7, K1.3
unnamed: J7.8, K1.2
unnamed: Q1.1 (B), R54.1
unnamed: Q2.1 (B), R55.1
unnamed: Q3.1 (B), R56.1
unnamed: Q4.1 (B), R57.1
unnamed: Q5.1 (B), R58.1
unnamed: Q6.1 (B), R59.1
unnamed: R10.1, R19.2, U2.3 (+)
unnamed: R11.1, R20.1, U2.6 (-)
unnamed: R12.1, R21.2, U2.5 (+)
unnamed: R5.1, R14.2, U1.2 (-)
unnamed: R6.1, R15.1, U1.3 (+)
unnamed: R7.1, R16.1, U1.6 (-)
unnamed: R8.1, R17.2, U1.5 (+)
unnamed: R9.1, R18.1, U2.2 (-)
unnamed: R22.1, U5.1
unnamed: R23.1, U5.3
unnamed: R24.1, U5.5
unnamed: R25.1, U5.7
unnamed: R26.1, U6.1
unnamed: R27.1, U6.3
unnamed: R28.1, U6.5
unnamed: R29.1, U6.7
unnamed: R34.1, R38.2
VCC: C4.1, J3.2, J3.4, J3.6, J3.8, J4.2, J4.4, J4.6, J4.8, L2.2, U4.1 (VIN)

Notes on the sheet:
VOLTAGE REGULATORS
IN: 7~~25V
OUT1: 5.0V
OUT2: 4.1V
4~~20mA ANALOG INPUTS
0~~24V DIGITAL INPUTS
0.0~~3.3V OUTPUTS
POWER DIGITAL OUTPUTS
0.0~~3.0V OUTPUTS
gain: 10
INPUT
7~~25V
SPARE FUSES FUSÍVEIS RESERVA

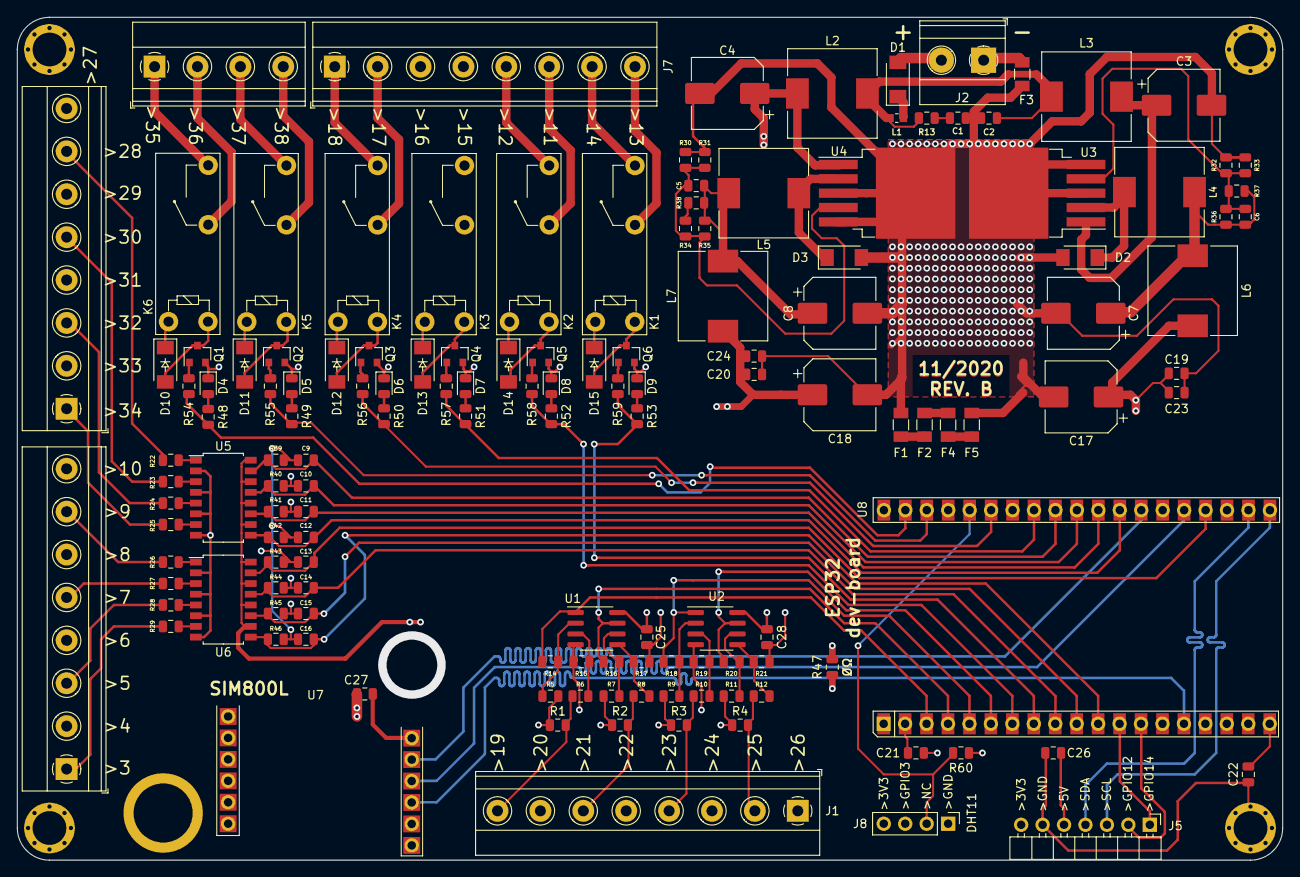
[picture p42: board ESP32-BOARD.kicad_pcb from above]

Board: 4 copper layers, 149.9 x 99.8 mm, 148 parts (0 on the bottom side), 106 nets.
