Gosmann/ESP32-board/(commit log)

2020-07-25 added files to the repo
    [ESP32-BOARD-B_Cu.gbr, ESP32-BOARD-B_Mask.gbr, ESP32-BOARD-B_Paste.gbr, ESP32-BOARD-B_SilkS.gbr, ESP32-BOARD-Edge_Cuts.gbr, ESP32-BOARD-F_Cu.gbr, ESP32-BOARD-F_Mask.gbr, ESP32-BOARD-F_Paste.gbr]
2020-07-26 changes made on the analog inputs
    [ESP32-BOARD.sch]
2020-07-26 arrumei as dimensoes dos furos
    [ESP32-BOARD.kicad_pcb, ESP32-BOARD.sch, circuit_test.ods]
2020-07-26 changes de boards to 4 layers
    [ESP32-BOARD.kicad_pcb]
2020-07-28 updates related to review B
    [ESP32-BOARD-B_Cu.gbr, ESP32-BOARD-B_Mask.gbr, ESP32-BOARD-B_Paste.gbr, ESP32-BOARD-B_SilkS.gbr, ESP32-BOARD-Edge_Cuts.gbr, ESP32-BOARD-F_Cu.gbr, ESP32-BOARD-F_Mask.gbr, ESP32-BOARD-F_Paste.gbr]
2020-07-28 added 3d models
    [ESP32-BOARD.sch]
2020-07-28 update on project
    [ESP32-BOARD.kicad_pcb, ESP32-BOARD.sch]
2020-10-14 modificacoes na placa
    [ESP32-BOARD.kicad_pcb, ESP32-BOARD.sch]
2020-10-21 atualizacao placa
    [ESP32-BOARD.kicad_pcb]
2020-11-04 update gerbers and production files
    [ESP32-BOARD-B_Cu.gbr, ESP32-BOARD-B_Mask.gbr, ESP32-BOARD-B_Paste.gbr, ESP32-BOARD-B_SilkS.gbr, ESP32-BOARD-Edge_Cuts.gbr, ESP32-BOARD-F_Cu.gbr, ESP32-BOARD-F_Mask.gbr, ESP32-BOARD-F_Paste.gbr]
